IgorDamiaodeOliveira/Bancada-tribometrica-para-estudo-de-perda-de-energia-por-atrito/(notices)

Notices in the files:
README.md:
License: MIT
